ScudeT/Maui-moves/images/foxglove_visualization.png

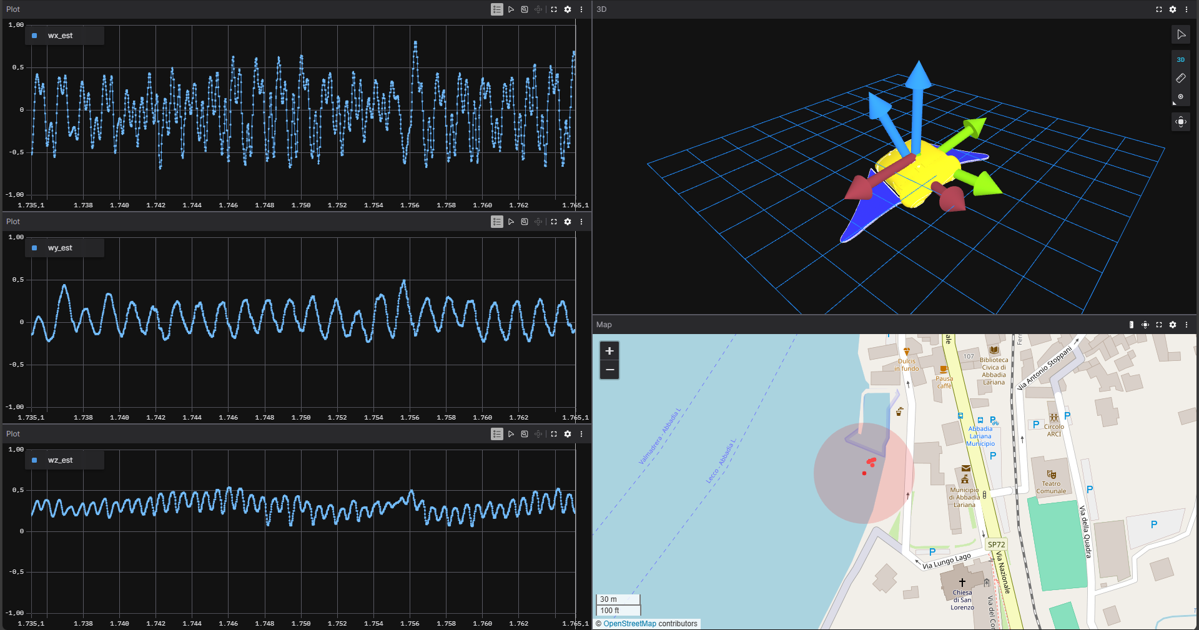
images/foxglove_visualization.png
