ScudeT/Maui-moves/images/Graphical abstract.png

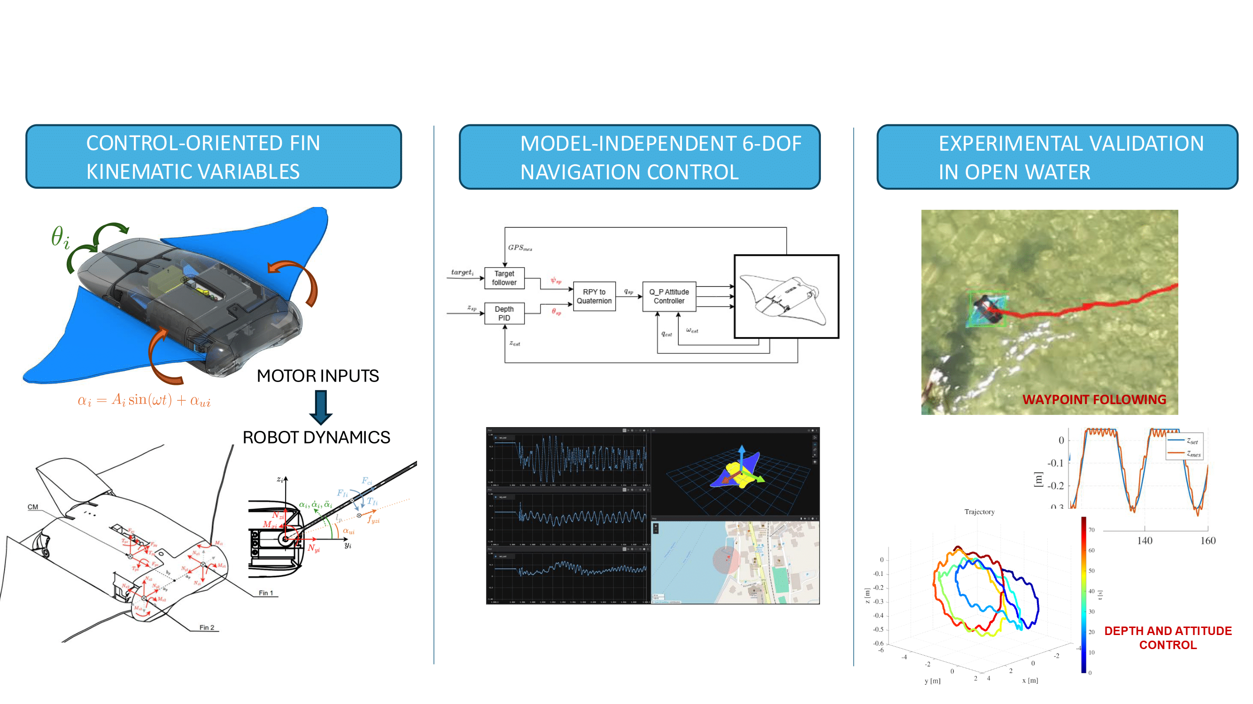
images/Graphical abstract.png
