ScudeT/Maui-moves/ros2_ws/src/maui_brain/parietal_lobe/description/meshes/finR.stl

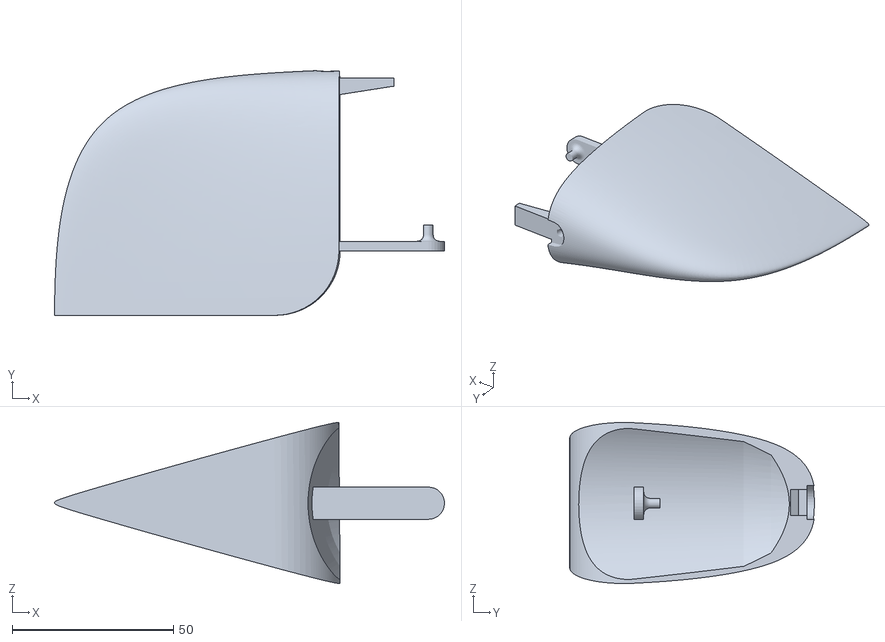
[picture p10: CAD file, 2026-10-09]
ros2_ws/src/maui_brain/parietal_lobe/description/meshes/finR.stl
121.0 x 75.9 x 50.0
