ScudeT/Maui-moves/ros2_ws/src/maui_brain/parietal_lobe/description/meshes/wing_right.stl

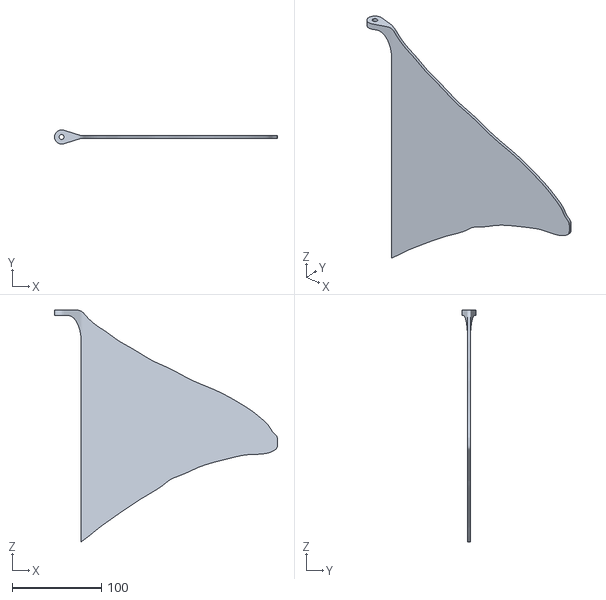
[picture p11: CAD file, 2026-10-09]
ros2_ws/src/maui_brain/parietal_lobe/description/meshes/wing_right.stl
250.2 x 16.0 x 260.0
