ScudeT/Maui-moves/ros2_ws/src/maui_brain/parietal_lobe/description/meshes/Fixed_body.stl

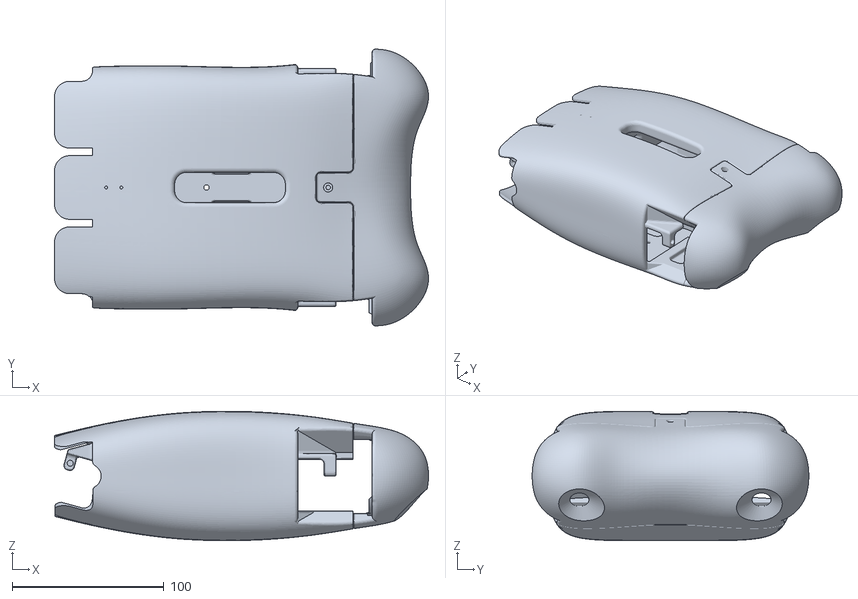
[picture p12: CAD file, 2026-10-09]
ros2_ws/src/maui_brain/parietal_lobe/description/meshes/Fixed_body.stl
246.5 x 182.3 x 85.3
