ScudeT/Maui-moves/ros2_ws/src/maui_brain/parietal_lobe/description/meshes/RaspiCamV3.stl

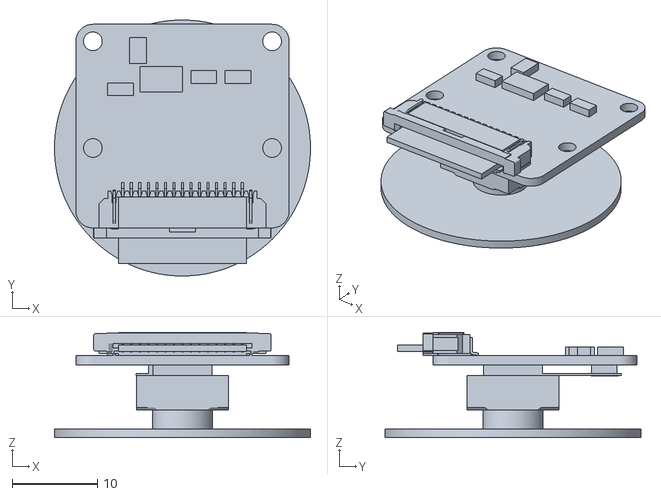
[picture p13: CAD file, 2026-10-09]
ros2_ws/src/maui_brain/parietal_lobe/description/meshes/RaspiCamV3.stl
30.0 x 30.0 x 12.3
