ScudeT/Maui-moves/(list of files, cad)

Other CAD files:
ros2_ws/src/maui_brain/parietal_lobe/description/meshes/finL.stl
ros2_ws/src/maui_brain/parietal_lobe/description/meshes/wing_left.stl
