ScudeT/Maui-moves/ros2_ws/src/maui_brain/brain_stem/config/PNS.yaml

mpu9250:
  ros__parameters:
    freq: 100.0        # Update rate of the heading estimation and data published (at least lower than the chosen FIFO_SAMPLE_RATE)
    frame_id: 'imu_link'
    filter: 1                 # 0: NONE, 1: MADGWICK, 2: MAHONY
    mag_bias: [-211.0, 322.0, -472.0]   # hard-iron center in mG, from record_mag + ellipsoid fit

    # sensor specific parameters
    ##### SENSOR SPECIFIC PARAMETERS ######
#                     0         1       2        3        4       5       6         7
# ACCEL_FS_SEL    {   2G,       4G,     8G,      16G      }
# GYRO_FS_SEL     {   250DPS,   500DPS, 1000DPS, 2000DPS  }
# MAG_OUTPUT_BITS {   14BITS,   16BITS  }
# FIFO_SAMPLE_RATE{   1000HZ,   500HZ,  333HZ,   250HZ,  200HZ,   167HZ,  143HZ,    125HZ, }
# GYRO_DLPF_CFG   {   250HZ,    184HZ,  92HZ,    41HZ,   20HZ,    10HZ,   5HZ,      3600HZ, }
# ACCEL_DLPF_CFG  {   218HZ_0,  218HZ_1, 99HZ,   45HZ,   21HZ,    10HZ,   5HZ,      420HZ, }
#
# more details at: https://invensense.tdk.com/wp-content/uploads/2015/02/PS-MPU-9250A-01-v1.1.pdf

    accel_fs_sel: 1           # Corresponds to ACCEL_FS_SEL::A4G
    gyro_fs_sel: 0            # Corresponds to GYRO_FS_SEL::G250DPS
    mag_output_bits: 0        # Corresponds to MAG_OUTPUT_BITS::M14BITS
    fifo_sample_rate: 1       # Corresponds to FIFO_SAMPLE_RATE::SMPL_500HZ
    gyro_dlpf_cfg: 3          # Corresponds to GYRO_DLPF_CFG::DLPF_41HZ
    accel_dlpf_cfg: 3         # Corresponds to ACCEL_DLPF_CFG::DLPF_45HZ
    g: 9.80665
    # acc_cov:  0.000644
    # w_cov: 0.000000335
    # acc_cov:  0.001
    # w_cov: 0.000001
    # rpy_cov: 0.0003
    acc_cov:  1.0
    w_cov:    0.01
    rpy_cov:  0.001

ms5837:
  ros__parameters:
    freq: 50.0
    frame_id: 'bar_link'
    offset: -0.13
    variance: 0.000000025

pca9685:
  ros__parameters:
    device: "/dev/i2c-1"
    address: 64           # 0x40 in hexadecimal is 64 in decimal
    frequency: 333
    timeout: [5000, 5000, 5000, 5000, 5000, 5000, 5000, 5000,
              5000, 5000, 5000, 5000, 5000, 5000, 5000, 5000]
    pwm_min: [0, 0, 0, 0, 0, 0, 0, 0, 0, 0, 0, 0, 0, 0, 0, 0]
    pwm_max: [65535, 65535, 65535, 65535, 65535, 65535, 65535, 65535,
              65535, 65535, 65535, 65535, 65535, 65535, 65535, 65535]
    timeout_value: [0, 0, 0, 0, 0, 0, 0, 0, 0, 0, 0, 0, 0, 0, 0, 0]

GPS:
  ros__parameters:
    freq: 2.0

button:
  ros__parameters:
    freq: 200.0             # Sampling frequency (Hz)
    gpio_line: 4
    press_time: 0.04        # Line must be mostly high this long to accept a press (s)
    release_time: 0.04      # Line must be mostly low this long to accept a release (s)
    refractory_time: 0.25   # Presses ignored for this long after a release (s)
    release: true
